sparx266/Commodore-64-SFX-Sound-Expander-Arduino-MIDI-V1/src/C64dmt3.h

/**
 * This file contains MIDI instrument defenitions for use with the OPL2 Audio Board library. These were converted from
 * the General MIDI timbres by The Fat Man(TM). This file contains the melodic instrments only.
 *
 * Instrument definition is based on Adlib instrument bank format.
 *  0 - Rhythm mode drum channel
 *		Drum channels are predefined by the YM3812 and cannot be redefined. Regular instruments have their channel set
 *		to 0x00 and can be assigned to any channel by the setInstrument function. Rhythm mode instruments can only be
 *		used when rhythm mode is active (see OPL2.setPercussion).
 *
 *  1 - Channel c, operator 1, register 0x20
 *		Tremolo(1) | Vibrato(1) | Sustain(1) | KSR(1) | Frequency multiplier (4)
 *
 *  2 - Channel c, operator 1, register 0x40
 *		Key scale level(2) | Output level(6)
 *
 *  3 - Channel c, operator 1, register 0x60
 *		Attack(4) | Decay(4)
 *
 *  4 - Channel c, operator 1, register 0x80
 *		Sustain(4) | Release(4)
 *
 *  5 - Channel c, register 0xC0
 *		Undefined(4) | Modulation feedback factor(3) | Synth type(1)
 *
 *  6 - Channel c, operator 1, register 0xE0
 *		Undefined(5) | Waveform(3)
 *
 *  7 - Channel c, operator 2, register 0x20 
 *  8 - Channel c, operator 2, register 0x40
 *  9 - Channel c, operator 2, register 0x60
 * 10 - Channel c, operator 2, register 0x80
 * 11 - Channel c, operator 2, register 0xE0
 */

//const unsigned char B1test[12]      PROGMEM = {0x00,0x01,0x30,0x4F,0x00,0xF0,0x00,0x90,0xFF,0x0F,0x06,0x00};
//Proper EPiano1 is below
const unsigned char Piano1[12]      PROGMEM = {0x00,0x21,0x52,0xE1,0xF4,0x0A,0x00,0x22,0x40,0xD3,0xF6,0x00};
//This is Organ B1 test
//const unsigned char Piano1[12]      PROGMEM = {0x00,0x01,0x4F,0xF0,0xFF,0x06,0x00,0x30,0x00,0x90,0x0F,0x00};
//const unsigned char Piano1[12]      PROGMEM = {0x00,0x01,0x4F,0x90,0xFF,0x06,0x00,0x30,0x00,0xF0,0x0F,0x00};
//End of test organ
const unsigned char EPiano1[12]     PROGMEM = {0x00,0x32,0x23,0xC1,0x34,0x0C,0x00,0x31,0x45,0xC1,0xF7,0x00};
const unsigned char Brass_3[12]     PROGMEM = {0x00,0x70,0x1A,0x41,0x35,0x0E,0x00,0x71,0x00,0x61,0x26,0x00};
const unsigned char Wah_Brass[12]   PROGMEM = {0x00,0x71,0x19,0x32,0x35,0x8E,0x00,0x71,0x03,0x44,0x2A,0x00};
const unsigned char BellBrass[12]   PROGMEM = {0x00,0x51,0x94,0x41,0x24,0x0E,0x00,0x72,0x08,0x62,0x02,0x00};
const unsigned char Trumpet[12]     PROGMEM = {0x00,0x71,0x1B,0x61,0x15,0x0E,0x00,0x71,0x00,0x8F,0x0E,0x00};
const unsigned char Horn[12]        PROGMEM = {0x00,0x70,0x4D,0x42,0x25,0x06,0x00,0x30,0x05,0x6F,0x06,0x00};
const unsigned char Trombone[12]    PROGMEM = {0x00,0x70,0x20,0x41,0x15,0x0E,0x00,0x70,0x00,0x6F,0x0E,0x00};
const unsigned char Tuba[12]        PROGMEM = {0x00,0x70,0x14,0x42,0x63,0x48,0x00,0x70,0x00,0x4F,0x07,0x00};
const unsigned char Strings1[12]    PROGMEM = {0x00,0x61,0x1D,0x64,0x02,0x0E,0x00,0x61,0x09,0x54,0x05,0x00};
const unsigned char Strings2MTA[12] PROGMEM = {0x00,0x61,0x1B,0x94,0x14,0x0E,0x00,0x61,0x09,0x54,0x06,0x00};
const unsigned char PluckedA[12]    PROGMEM = {0x00,0x61,0x1B,0xC5,0xF5,0x0E,0x00,0x61,0x09,0x96,0xF6,0x00};
const unsigned char SynthStr[12]    PROGMEM = {0x00,0x71,0x17,0x94,0x34,0x4E,0x00,0x41,0x09,0x84,0x04,0x00};
const unsigned char Violin[12]      PROGMEM = {0x00,0x71,0x1B,0xF1,0x24,0x4E,0x00,0x31,0x00,0x41,0x16,0x00};
const unsigned char Cello[12]       PROGMEM = {0x00,0x70,0x1C,0xF1,0x25,0x8E,0x00,0x30,0x00,0x41,0x14,0x00};
const unsigned char Bagpipes[12]    PROGMEM = {0x00,0x31,0x07,0xA6,0x0F,0x08,0x00,0x24,0x07,0x80,0x1E,0x00};
const unsigned char Piccalo[12]     PROGMEM = {0x00,0x72,0x52,0x96,0xAB,0x80,0x00,0x72,0x00,0x6F,0x08,0x00};
const unsigned char Clarinet[12]    PROGMEM = {0x00,0x72,0x9A,0x51,0x75,0x4A,0x00,0x31,0x05,0x6F,0x09,0x00};
const unsigned char Oboe[12]        PROGMEM = {0x00,0x71,0x93,0x40,0xF4,0xCA,0x00,0x77,0x0A,0x4F,0x07,0x00};
const unsigned char JazzFlute[12]   PROGMEM = {0x00,0x71,0x1D,0x84,0x66,0x8A,0x00,0x71,0x00,0x41,0x18,0x00};
const unsigned char Saxophone[12]   PROGMEM = {0x00,0x70,0x87,0x6F,0x03,0x48,0x00,0xB0,0x08,0x52,0x25,0x00};
const unsigned char Harmonica[12]   PROGMEM = {0x00,0x71,0x1B,0x73,0x02,0x0E,0x00,0xF4,0x03,0x3F,0x06,0x00};
const unsigned char EPiano3[12]     PROGMEM = {0x00,0x16,0x71,0xF6,0x25,0x00,0x00,0x10,0x00,0xF1,0xE5,0x00};
const unsigned char Organ1A[12]     PROGMEM = {0x00,0x21,0x10,0x89,0x1F,0x0B,0x00,0x24,0x16,0x9A,0x0E,0x00};
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
const unsigned char ORGANVL[12]     PROGMEM = {0x00,0x32,0x1C,0xB0,0x03,0x0E,0x00,0x62,0x00,0x75,0xF8,0x01};
const unsigned char ORGNOR01[12]    PROGMEM = {0x00,0x65,0xD2,0xF1,0x03,0x02,0x00,0x71,0x80,0x81,0x05,0x00};
const unsigned char ORGNOR02[12]    PROGMEM = {0x00,0x24,0x80,0xFF,0x0F,0x01,0x00,0x21,0x80,0xFF,0x0F,0x00};
const unsigned char ORGNOR03[12]    PROGMEM = {0x00,0x64,0x86,0xFF,0x0F,0x01,0x00,0x21,0x86,0xFF,0x0F,0x00};
const unsigned char ORGNOR04[12]    PROGMEM = {0x00,0x03,0x5B,0xF0,0x1F,0x0A,0x00,0x01,0x80,0xF0,0x1F,0x00};
const unsigned char ORGPEDAL[12]    PROGMEM = {0x00,0x21,0x41,0xD7,0x0B,0x03,0x00,0x30,0x00,0xB7,0x0B,0x00};
const unsigned char DOCORG1[12]     PROGMEM = {0x00,0xF1,0xC0,0xF1,0x05,0x0C,0x00,0xF1,0x80,0xF1,0x05,0x00};
const unsigned char DOCORG2[12]     PROGMEM = {0x00,0xE2,0xC0,0xF1,0x05,0x04,0x00,0xF2,0x40,0xF1,0x05,0x00};
const unsigned char DOCORG3[12]     PROGMEM = {0x00,0xE3,0xC0,0xF1,0x05,0x0A,0x00,0xF3,0x40,0xF1,0x05,0x00};
const unsigned char DOCORG[12]      PROGMEM = {0x00,0xE5,0xC0,0xF1,0x05,0x02,0x00,0xF1,0x00,0xF1,0x05,0x00};


// Instrument pointer array to access instruments by MIDI program.Should be unsigned char in line underneath
const unsigned char * midiInstruments[]={Piano1,EPiano1,Brass_3,Wah_Brass,BellBrass,Trumpet,Horn,Trombone,Tuba,Strings1,Strings2MTA,PluckedA,SynthStr,Violin,Cello,Bagpipes,Piccalo,Clarinet,Oboe,JazzFlute,Saxophone,Harmonica,EPiano3,Organ1A,Organ2A,Organ3A,ReedOrgan,PipeBrass,Pipeorg1,Harpschd1,Harpschd2,Clavichord,Celeste,ToyPiano,Accordian,BluesGuitar,SpaniGuitar,DistGuitar,ElecBass1,WalkBass,Banjo,Lute,Harp,JawHarp1,JawHarp2,Sitar,Vibes2,Glock2,Koto2,SteelDrum,Marimba,Xylophone,TubeBells,Synth1,Synth3,Synbass1,Synbass2,SynthLead,Syntharpsi,Voice,MeatyJob,NiceSound,Chimes,Guitar,Vibraphone,Brass,StringsMT,Piano,Organ1,Organ2,Harpsi,Flute,Synth1A,Synth2A,Synth3A,Banjo,Mellow,SpaceBell,Strings2,Plucked,Raindrops,Cosmicblow,SweetFlute,Alien,Glock,Synthbass,EPiano_2,BassMoto,MetalHarp,Voice1,Strings3,Plucked2,PlinkStr,SpaceBell2,PhilGlass,SitarSax,Whistle,Synth4,Fantasy,Borgan1,Borgan2,Borgan3,Borgan4,Borgan5,Borgan6,ELOrgan2,Human3,Org9,Organ1or,ORGAN13,ORGAN2,ORGAN2A,ORGAN3,ORGAN5,ORGANFD1,ORGANK,ORGANVL,ORGNOR01,ORGNOR02,ORGNOR03,ORGNOR04,ORGPEDAL,DOCORG1,DOCORG2,DOCORG3,DOCORG};
    
